ErickaUEFS/Coprocessador-Grafico-Programavel/soc_system/soc_system_inst.v

	soc_system u0 (
		.clk_clk                               (<connected-to-clk_clk>),                               //                       clk.clk
		.hps_0_f2h_cold_reset_req_reset_n      (<connected-to-hps_0_f2h_cold_reset_req_reset_n>),      //  hps_0_f2h_cold_reset_req.reset_n
		.hps_0_f2h_debug_reset_req_reset_n     (<connected-to-hps_0_f2h_debug_reset_req_reset_n>),     // hps_0_f2h_debug_reset_req.reset_n
		.hps_0_f2h_stm_hw_events_stm_hwevents  (<connected-to-hps_0_f2h_stm_hw_events_stm_hwevents>),  //   hps_0_f2h_stm_hw_events.stm_hwevents
		.hps_0_f2h_warm_reset_req_reset_n      (<connected-to-hps_0_f2h_warm_reset_req_reset_n>),      //  hps_0_f2h_warm_reset_req.reset_n
		.hps_0_h2f_reset_reset_n               (<connected-to-hps_0_h2f_reset_reset_n>),               //           hps_0_h2f_reset.reset_n
		.hps_0_hps_io_hps_io_emac1_inst_TX_CLK (<connected-to-hps_0_hps_io_hps_io_emac1_inst_TX_CLK>), //              hps_0_hps_io.hps_io_emac1_inst_TX_CLK
		.hps_0_hps_io_hps_io_emac1_inst_TXD0   (<connected-to-hps_0_hps_io_hps_io_emac1_inst_TXD0>),   //                          .hps_io_emac1_inst_TXD0
		.hps_0_hps_io_hps_io_emac1_inst_TXD1   (<connected-to-hps_0_hps_io_hps_io_emac1_inst_TXD1>),   //                          .hps_io_emac1_inst_TXD1
		.hps_0_hps_io_hps_io_emac1_inst_TXD2   (<connected-to-hps_0_hps_io_hps_io_emac1_inst_TXD2>),   //                          .hps_io_emac1_inst_TXD2
		.hps_0_hps_io_hps_io_emac1_inst_TXD3   (<connected-to-hps_0_hps_io_hps_io_emac1_inst_TXD3>),   //                          .hps_io_emac1_inst_TXD3
		.hps_0_hps_io_hps_io_emac1_inst_RXD0   (<connected-to-hps_0_hps_io_hps_io_emac1_inst_RXD0>),   //                          .hps_io_emac1_inst_RXD0
		.hps_0_hps_io_hps_io_emac1_inst_MDIO   (<connected-to-hps_0_hps_io_hps_io_emac1_inst_MDIO>),   //                          .hps_io_emac1_inst_MDIO
		.hps_0_hps_io_hps_io_emac1_inst_MDC    (<connected-to-hps_0_hps_io_hps_io_emac1_inst_MDC>),    //                          .hps_io_emac1_inst_MDC
		.hps_0_hps_io_hps_io_emac1_inst_RX_CTL (<connected-to-hps_0_hps_io_hps_io_emac1_inst_RX_CTL>), //                          .hps_io_emac1_inst_RX_CTL
		.hps_0_hps_io_hps_io_emac1_inst_TX_CTL (<connected-to-hps_0_hps_io_hps_io_emac1_inst_TX_CTL>), //                          .hps_io_emac1_inst_TX_CTL
		.hps_0_hps_io_hps_io_emac1_inst_RX_CLK (<connected-to-hps_0_hps_io_hps_io_emac1_inst_RX_CLK>), //                          .hps_io_emac1_inst_RX_CLK
		.hps_0_hps_io_hps_io_emac1_inst_RXD1   (<connected-to-hps_0_hps_io_hps_io_emac1_inst_RXD1>),   //                          .hps_io_emac1_inst_RXD1
		.hps_0_hps_io_hps_io_emac1_inst_RXD2   (<connected-to-hps_0_hps_io_hps_io_emac1_inst_RXD2>),   //                          .hps_io_emac1_inst_RXD2
		.hps_0_hps_io_hps_io_emac1_inst_RXD3   (<connected-to-hps_0_hps_io_hps_io_emac1_inst_RXD3>),   //                          .hps_io_emac1_inst_RXD3
		.hps_0_hps_io_hps_io_qspi_inst_IO0     (<connected-to-hps_0_hps_io_hps_io_qspi_inst_IO0>),     //                          .hps_io_qspi_inst_IO0
		.hps_0_hps_io_hps_io_qspi_inst_IO1     (<connected-to-hps_0_hps_io_hps_io_qspi_inst_IO1>),     //                          .hps_io_qspi_inst_IO1
		.hps_0_hps_io_hps_io_qspi_inst_IO2     (<connected-to-hps_0_hps_io_hps_io_qspi_inst_IO2>),     //                          .hps_io_qspi_inst_IO2
		.hps_0_hps_io_hps_io_qspi_inst_IO3     (<connected-to-hps_0_hps_io_hps_io_qspi_inst_IO3>),     //                          .hps_io_qspi_inst_IO3
		.hps_0_hps_io_hps_io_qspi_inst_SS0     (<connected-to-hps_0_hps_io_hps_io_qspi_inst_SS0>),     //                          .hps_io_qspi_inst_SS0
		.hps_0_hps_io_hps_io_qspi_inst_CLK     (<connected-to-hps_0_hps_io_hps_io_qspi_inst_CLK>),     //                          .hps_io_qspi_inst_CLK
		.hps_0_hps_io_hps_io_sdio_inst_CMD     (<connected-to-hps_0_hps_io_hps_io_sdio_inst_CMD>),     //                          .hps_io_sdio_inst_CMD
		.hps_0_hps_io_hps_io_sdio_inst_D0      (<connected-to-hps_0_hps_io_hps_io_sdio_inst_D0>),      //                          .hps_io_sdio_inst_D0
		.hps_0_hps_io_hps_io_sdio_inst_D1      (<connected-to-hps_0_hps_io_hps_io_sdio_inst_D1>),      //                          .hps_io_sdio_inst_D1
		.hps_0_hps_io_hps_io_sdio_inst_CLK     (<connected-to-hps_0_hps_io_hps_io_sdio_inst_CLK>),     //                          .hps_io_sdio_inst_CLK
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
		.hps_0_hps_io_hps_io_gpio_inst_GPIO54  (<connected-to-hps_0_hps_io_hps_io_gpio_inst_GPIO54>),  //                          .hps_io_gpio_inst_GPIO54
		.hps_0_hps_io_hps_io_gpio_inst_GPIO61  (<connected-to-hps_0_hps_io_hps_io_gpio_inst_GPIO61>),  //                          .hps_io_gpio_inst_GPIO61
		.memory_mem_a                          (<connected-to-memory_mem_a>),                          //                    memory.mem_a
		.memory_mem_ba                         (<connected-to-memory_mem_ba>),                         //                          .mem_ba
		.memory_mem_ck                         (<connected-to-memory_mem_ck>),                         //                          .mem_ck
		.memory_mem_ck_n                       (<connected-to-memory_mem_ck_n>),                       //                          .mem_ck_n
		.memory_mem_cke                        (<connected-to-memory_mem_cke>),                        //                          .mem_cke
		.memory_mem_cs_n                       (<connected-to-memory_mem_cs_n>),                       //                          .mem_cs_n
		.memory_mem_ras_n                      (<connected-to-memory_mem_ras_n>),                      //                          .mem_ras_n
		.memory_mem_cas_n                      (<connected-to-memory_mem_cas_n>),                      //                          .mem_cas_n
		.memory_mem_we_n                       (<connected-to-memory_mem_we_n>),                       //                          .mem_we_n
		.memory_mem_reset_n                    (<connected-to-memory_mem_reset_n>),                    //                          .mem_reset_n
		.memory_mem_dq                         (<connected-to-memory_mem_dq>),                         //                          .mem_dq
		.memory_mem_dqs                        (<connected-to-memory_mem_dqs>),                        //                          .mem_dqs
		.memory_mem_dqs_n                      (<connected-to-memory_mem_dqs_n>),                      //                          .mem_dqs_n
		.memory_mem_odt                        (<connected-to-memory_mem_odt>),                        //                          .mem_odt
		.memory_mem_dm                         (<connected-to-memory_mem_dm>),                         //                          .mem_dm
		.memory_oct_rzqin                      (<connected-to-memory_oct_rzqin>),                      //                          .oct_rzqin
		.reset_reset_n                         (<connected-to-reset_reset_n>),                         //                     reset.reset_n
		.mmio_conduit_fila_cheia               (<connected-to-mmio_conduit_fila_cheia>),               //              mmio_conduit.fila_cheia
		.mmio_conduit_fila_escrever            (<connected-to-mmio_conduit_fila_escrever>),            //                          .fila_escrever
		.mmio_conduit_fila_instrucao           (<connected-to-mmio_conduit_fila_instrucao>)            //                          .fila_instrucao
	);
